WyattJordan/Arduino-Pixelstick-4.0/Parts List.xlsx

Type | Value | Package | Digikey # | Manu. # | cost | quantity | spares | total | link | Description | total cost | This cost can be greatly reduced by using less dense LED strips which would also require less power.
Capacitor | 0.22uF | 1206 | 399-1251-1-ND | C1206C224K5RACTU | 0.21 | 6 | 3 | 1.89 | https://www.digikey.com/product-detail/en/kemet/C1206C224K5RACTU/399-1251-1-ND/411526 | Debounce Encoders | 105.05
Capacitor | 3.3uF | 1206 | 399-3140-1-ND | C1206C335K3PACTU | 0.44 | 3 | 2 | 2.2 | https://www.digikey.com/product-detail/en/kemet/C1206C335K3PACTU/399-3140-1-ND/551645 | Debounce switches
Resistor | 10k | 805 | RNCP0805FTD10K0CT-ND | RNCP0805FTD10K0 | 0.1 | 9 | 3 | 1.2 | https://www.digikey.com/product-detail/en/stackpole-electronics-inc/RNCP0805FTD10K0/RNCP0805FTD10K0CT-ND/2240601 | 3 for switches, 2 for logic shifter
Resistor | 20k | 805 | RNCP0805FTD20K0CT-ND | RNCP0805FTD20K0 | 0.1 | 2 | 2 | 0.4 | https://www.digikey.com/product-detail/en/stackpole-electronics-inc/RNCP0805FTD20K0/RNCP0805FTD20K0CT-ND/2240611 | for voltage dividers
Regulator | 5V, .8A | TO-220-3 | 497-7311-5-ND | LD1117V50 | 0.55 | 1 | 1 | 1.1 | https://www.digikey.com/product-detail/en/stmicroelectronics/LD1117V50/497-7311-5-ND/1663515 | for powering MKR
MOSFET | 60V rev, 10O | SOT-23 | DMP510DL-7DICT-ND | DMP510DL-7 | 0.45 | 2 | 1 | 1.35 | https://www.digikey.com/product-detail/en/diodes-incorporated/DMP510DL-7/DMP510DL-7DICT-ND/5699727 | reverse power protection mosfet
Capacitor | 1mF, 10V | through hole | P15319CT-ND | EEU-FR1A152B | 0.78 | 1 | 0 | 0.78 | https://www.digikey.com/product-detail/en/panasonic-electronic-components/EEU-FR1A152B/P15319CT-ND/3072199 | LED initial current protection capacitor
JFET |  | SOT-23 | BSS138CT-ND | BSS138 | 0.32 | 2 | 1 | 0.96 | https://www.digikey.com/product-detail/en/on-semiconductor/BSS138/BSS138CT-ND/244294 | logic level shifter for LCD
Arduino | MKR Zero | PCB | 1050-1137-ND | ABX00012 | 24.64 | 1 | 0 | 24.64 | https://www.digikey.com/products/en/development-boards-kits-programmers/evaluation-boards-embedded-mcu-dsp/786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 | arduino board
LCD |  | PCB |  |  | 6 | 1 | 0 | 6 | https://www.banggood.com/IIC-I2C-1602-Blue-Backlight-LCD-Display-Module-For-Arduino-p-950726.html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 | LCD screen
Batteries | C | C Batt |  |  | 17 | 1 | 0 | 17 | https://www.amazon.com/EBL-Capacity-Rechargeable-Batteries-Included/dp/B00FHVM7GC | rechargeable batteries, 4 of these makes a 5V supply, you could use any 5v supply that can source enough current for your LED strip where the current required = NUM_LEDS * 0.042 A for SM 5050 RGB LEDS
LED strip | SM 5050 | PCB |  |  | 18.42 | 2 | 0 | 36.84 | https://www.aliexpress.com/item/1m-4m-5m-WS2812B-Smart-led-pixel-strip-Black-White-PCB-30-60-144-leds-m/2036819167.html | 144 LED/m, WS2812B
Encoder | KY-040 | PCB | Amazon (5pcs) |  | 10.69 | 1 | 0 | 10.69 | https://www.amazon.com/Cylewet-Encoder-15%C3%9716-5-Arduino-CYT1062/dp/B06XQTHDRR | encoders
