WyattJordan/Arduino-Pixelstick-4.0/(list of files, drawings)

Other design files:
PCB_Design.pcb
